yusufElnady/Ultrasound-NDT-Main-Board/Documents/jlc_BOM.xlsx

Comment | Designator | Footprint | Quantity
4 pF | C201,C207 | Capacitor_SMD:C_0603_1608Metric | 2
22 pF | C202,C206 | Capacitor_SMD:C_0603_1608Metric | 2
1uF | C203,C209,C601,C603,C606,C613,C614 | Capacitor_SMD:C_0603_1608Metric | 7
22uF | C204,C505,C506,C507,C511,C512 | Capacitor_SMD:C_0805_2012Metric | 6
150pF | C205,C208 | Capacitor_SMD:C_0603_1608Metric | 2
100nF | C210,C211,C212,C213,C401,C501,C508 | Capacitor_SMD:C_0603_1608Metric | 7
1pF | C301,C305 | Capacitor_SMD:C_0402_1005Metric | 2
0.9pF | C302 | Capacitor_SMD:C_0402_1005Metric | 1
0.6pF | C303 | Capacitor_SMD:C_0402_1005Metric | 1
100pF | C304,C312,C315,C316,C322 | Capacitor_SMD:C_0402_1005Metric | 5
12pF | C306,C307 | Capacitor_SMD:C_0402_1005Metric | 2
3pF | C308,C309,C313 | Capacitor_SMD:C_0402_1005Metric | 3
7pF | C310 | Capacitor_SMD:C_0402_1005Metric | 1
3.9pF | C311,C321,C323 | Capacitor_SMD:C_0402_1005Metric | 3
2.6pF | C314 | Capacitor_SMD:C_0402_1005Metric | 1
2.4pF | C317,C318 | Capacitor_SMD:C_0402_1005Metric | 2
1.1pF | C319 | Capacitor_SMD:C_0402_1005Metric | 1
5.1pF | C320 | Capacitor_SMD:C_0402_1005Metric | 1
10uF | C502,C503,C504,C509,C510 | Capacitor_SMD:C_0805_2012Metric | 5
LED | D201,D501,D502,D503,D504 | LED_SMD:LED_0805_2012Metric | 5
015402.5DR | F501 | 015402.5DR:0154Series_LTF | 1
0154001.DR | F502,F503,F504,F505 | 0154001.DR:FUSE_0154001.DR | 4
1.5K 0.5A | FB501 | Inductor_SMD:L_0603_1608Metric | 1
6.8uH | L201 | Inductor_SMD:L_0805_2012Metric | 1
20nH | L301 | Inductor_SMD:L_0402_1005Metric | 1
3.7nH | L302,L303 | Inductor_SMD:L_0402_1005Metric | 2
3.4nH | L304,L311,L312 | Inductor_SMD:L_0402_1005Metric | 3
3.9nH | L305 | Inductor_SMD:L_0402_1005Metric | 1
10nH | L306,L308 | Inductor_SMD:L_0402_1005Metric | 2
22nH | L307 | Inductor_SMD:L_0402_1005Metric | 1
6.8nH | L309,L310 | Inductor_SMD:L_0402_1005Metric | 2
0.6nH | L313 | Inductor_SMD:L_0402_1005Metric | 1
1nH | L314,L315 | Inductor_SMD:L_0402_1005Metric | 2
12nH | L316,L318 | Inductor_SMD:L_0402_1005Metric | 2
27nH | L317 | Inductor_SMD:L_0402_1005Metric | 1
3nH | L319 | Inductor_SMD:L_0402_1005Metric | 1
5.1nH | L320 | Inductor_SMD:L_0402_1005Metric | 1
1.9nH | L321 | Inductor_SMD:L_0402_1005Metric | 1
TPSM84338RCJR | PS501 | TPSM84338RCJR:CONV_TPSM84338RCJR | 1
1k | R201,R202,R203,R204,R206,R207,R208,R209,R210,R211,R212,R213,R504 | Resistor_SMD:R_0603_1608Metric | 13
330R | R205,R508,R509 | Resistor_SMD:R_0603_1608Metric | 3
2.2K | R401,R402,R403 | Resistor_SMD:R_0603_1608Metric | 3
3k | R501 | Resistor_SMD:R_0603_1608Metric | 1
2k | R502 | Resistor_SMD:R_0603_1608Metric | 1
18k | R503 | Resistor_SMD:R_0603_1608Metric | 1
72.3k | R505 | Resistor_SMD:R_0603_1608Metric | 1
10k | R506 | Resistor_SMD:R_0603_1608Metric | 1
500R | R507 | Resistor_SMD:R_0603_1608Metric | 1
6.65k | R601,R611 | Resistor_SMD:R_0603_1608Metric | 2
1.91k | R602,R603,R607,R608 | Resistor_SMD:R_0603_1608Metric | 4
1.5k | R604,R606 | Resistor_SMD:R_0603_1608Metric | 2
CC1354P106T0RGZR | U201 | CC1354P106T0RGZR:VQFN48_RGZ_TEX | 1
LTC1694CS5TRMPBF | U202 | LTC1694CS5TRMPBF:SOT95P280X100-5N | 1
MX25R1635FZUIL0 | U401 | MX25R1635FZUIL0:USON-8L-2X3X0P6_MAC | 1
AZ1117CH2-3.3 | U501,U502 | Package_TO_SOT_SMD:SOT-223-3_TabPin2 | 2
TLV9002IDR | U602 | TLV9002IDR:SOIC127P599X175-8N | 1
ABM11W-48.0000MHZ-7-B1U-T3 | Y201 | ABM11W-48.0000MHZ-7-B1U-T3:XTAL_ABM11W-48.0000MHZ-7-B1U-T3 | 1
ABS07-32.768KHZ-T | Y202 | ABS07-32.768KHZ-T:XTAL_ABS07-32.768KHZ-T | 1
