yusufElnady/Ultrasound-NDT-Main-Board/Main Board - NDT.kicad_pcb

## KiCad design Main Board - NDT.kicad_pcb (2026-04-28)

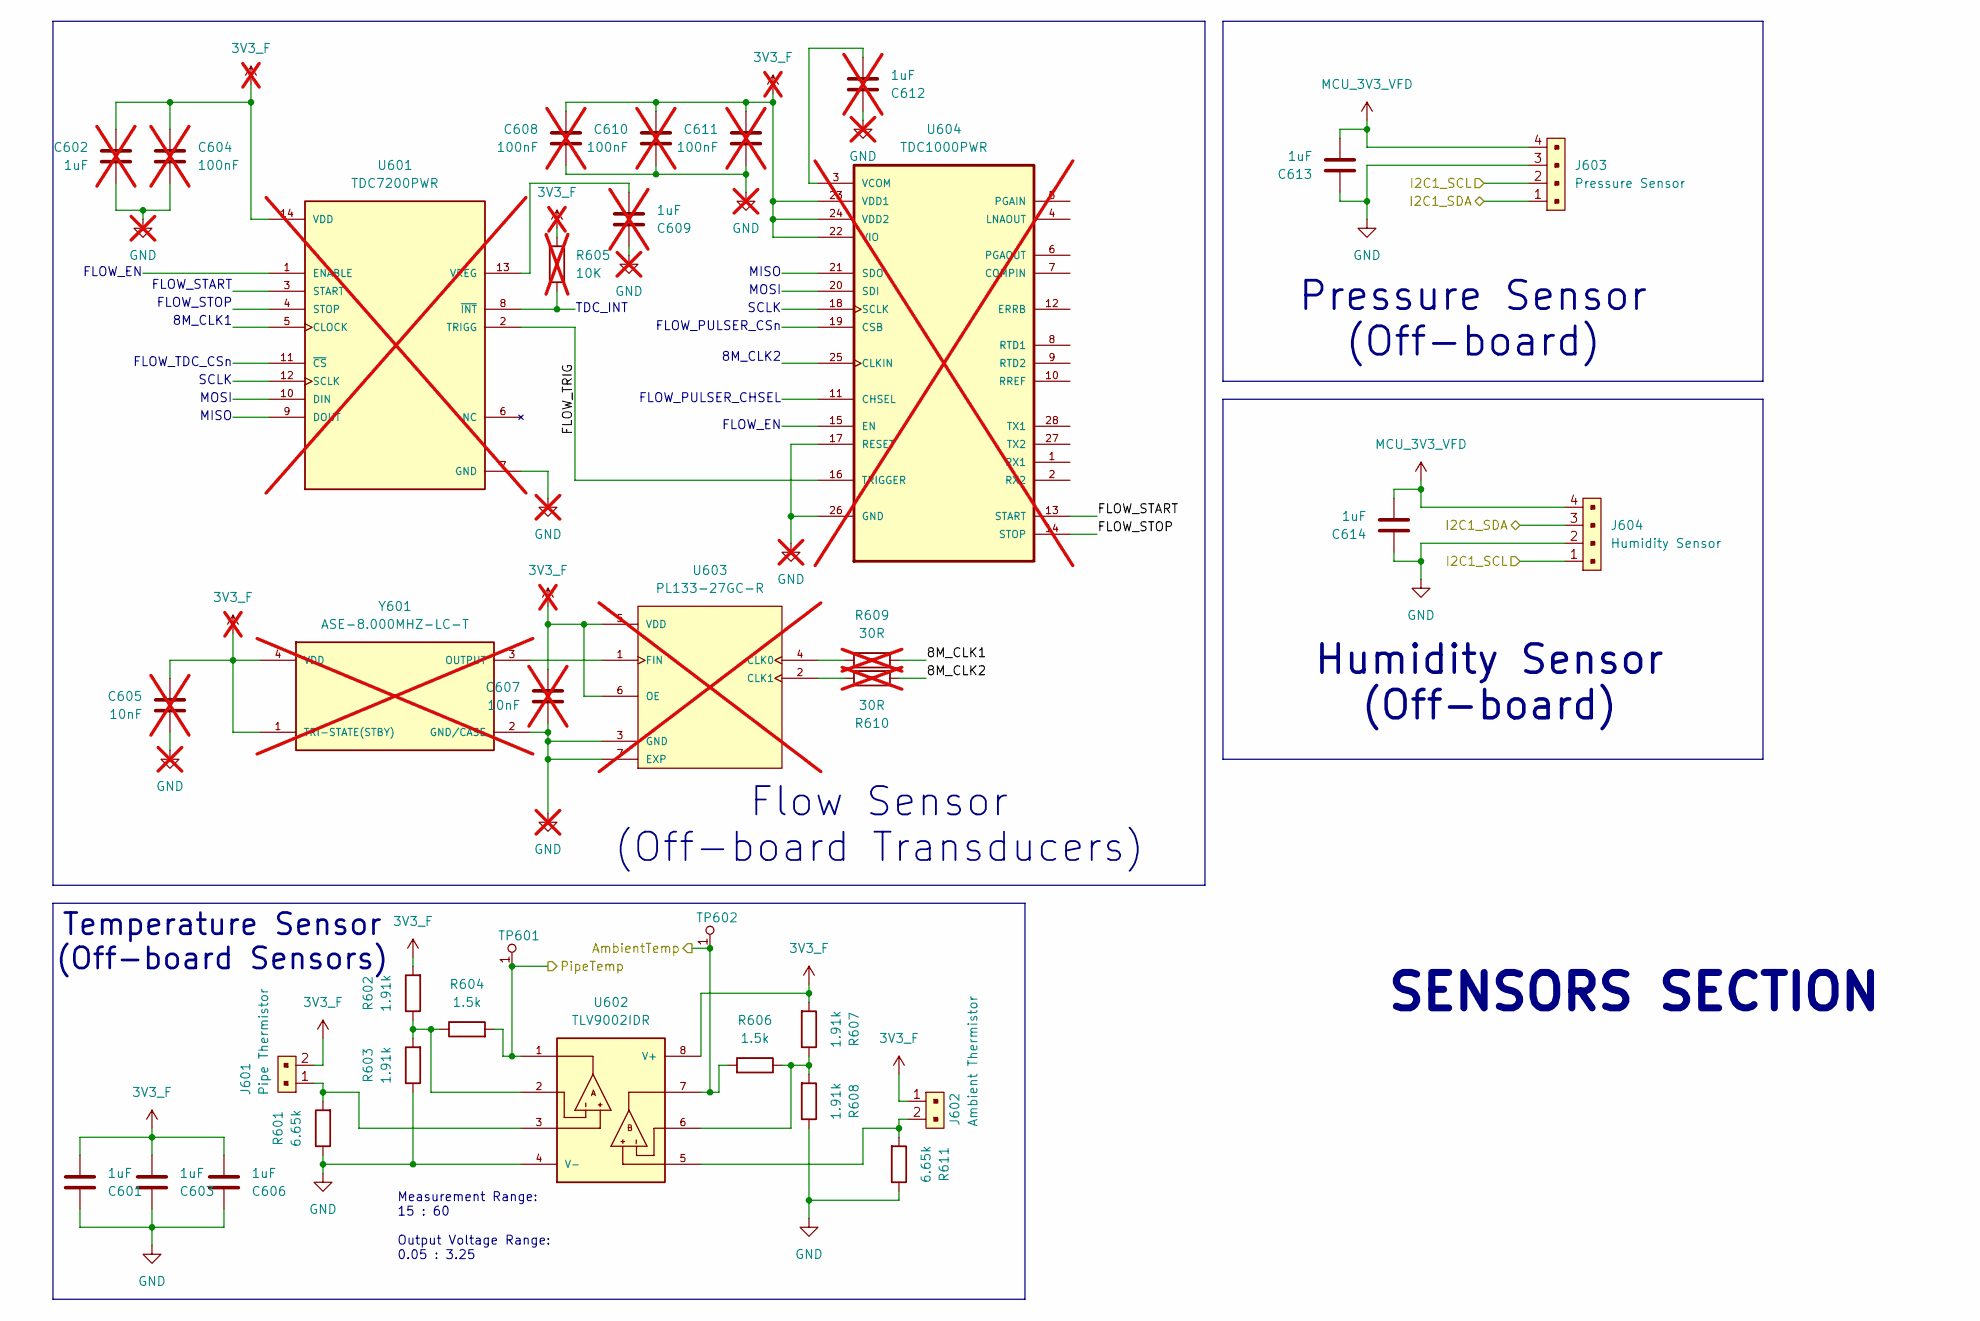
[picture p7: schematic sensors.kicad_sch]

Parts:
C601, C603, C606, C613, C614: 1uF; C_0603_1608Metric
C602, C609, C612: 1uF; not fitted
C604, C608, C610, C611: 100nF; C_0603_1608Metric; not fitted
C605, C607: 10nF; C_0603_1608Metric; not fitted
J601: Pipe Thermistor; PinHeader_1x2_P2mm_Drill1mm_RA; MPN S2B-PH-K-S(LF)(SN); Digi-Key_PN 455-1719-ND
J602: Ambient Thermistor; PinHeader_1x2_P2mm_Drill1mm_RA; MPN S2B-PH-K-S(LF)(SN); Digi-Key_PN 455-1719-ND
J603: Pressure Sensor; PinHeader_1x4_P2.5mm_Drill1.1mm; MPN B4B-XH-A(LF)(SN); Digi-Key_PN 455-2249-ND
J604: Humidity Sensor; PinHeader_1x4_P2.5mm_Drill1.1mm; MPN B4B-XH-A(LF)(SN); Digi-Key_PN 455-2249-ND
R601, R611: 6.65k; R_0603_1608Metric
R602, R603, R607, R608: 1.91k; R_0603_1608Metric
R604, R606: 1.5k; R_0603_1608Metric
R605: 10K; not fitted
R609, R610: 30R; not fitted
TP601, TP602: RCT-0C; PROBE_PAD_0805; MPN RCT-0C; Digi-Key_PN A106144CT-ND
U601: TDC7200PWR; SOP65P640X120-14N; PARTREV D; not fitted
U602: TLV9002IDR; SOIC127P599X175-8N; PARTREV O
U603: PL133-27GC-R; SON40P130X200X60-7N; PARTREV 09/13/13; not fitted
U604: TDC1000PWR; SOP65P640X120-28N; not fitted
Y601: ASE-8.000MHZ-LC-T; XTAL_ASE-8.000MHZ-LC-T; PARTREV 02-18-22; not fitted

Connections:
3V3_F: C601.2, C602.1, C603.2, C604.1, C605.1, C606.2, C607.1, C608.1, C610.1, C611.1, J601.2, J602.1, R602.2, R605.1, R607.2, U601.14 (VDD), U602.8 (V+), U603.5 (VDD), U603.6 (OE), U604.22 (VIO), U604.23 (VDD1), U604.24 (VDD2), Y601.1 (TRI-STATE(STBY)), Y601.4 (VDD); also elsewhere on the board
/MCU/AmbientTemp: R606.2, TP602.1, U602.7; also elsewhere on the board
/MCU/I2C1_SCL: J603.2, J604.1; also elsewhere on the board
/MCU/I2C1_SDA: J603.1, J604.3; also elsewhere on the board
/MCU/PipeTemp: R604.2, TP601.1, U602.1; also elsewhere on the board
GND: C601.1, C602.2, C603.1, C604.2, C605.2, C606.1, C607.2, C608.2, C609.1, C610.2, C611.2, C612.1, C613.1, C614.1, J603.3, J604.2, R601.1, R603.1, R608.1, R611.1, U601.7 (GND), U602.4 (V-), U603.3 (GND), U603.7 (EXP), U604.17 (RESET), U604.26 (GND), Y601.2 (GND/CASE); also elsewhere on the board
MCU_3V3_VFD: C613.2, C614.2, J603.4, J604.4; also elsewhere on the board
unnamed: C609.2, U601.13 (VREG)
unnamed: C612.2, U604.3 (VCOM)
unnamed: J601.1, R601.2, U602.3
unnamed: J602.2, R611.2, U602.5
unnamed: R602.1, R603.2, R604.1, U602.2
unnamed: R605.2, U601.8 (~INT)
unnamed: R606.1, R607.1, R608.2, U602.6
unnamed: R609.1, U603.4 (CLK0)
unnamed: R610.2, U603.2 (CLK1)
unnamed: U601.2 (TRIGG), U604.16 (TRIGGER)
unnamed: U603.1 (FIN), Y601.3 (OUTPUT)

Notes on the sheet:
SCLK
MISO
FLOW_STOP
MOSI
FLOW_TDC_CSn
Pressure Sensor (Off-board)
Humidity Sensor (Off-board)
Measurement Range: 15 : 60 Output Voltage Range: 0.05 : 3.25
Flow Sensor (Off-board Transducers)
FLOW_PULSER_CHSEL
FLOW_EN
SENSORS SECTION
FLOW_START
TDC_INT
8M_CLK2
8M_CLK1
Temperature Sensor (Off-board Sensors)
FLOW_PULSER_CSn

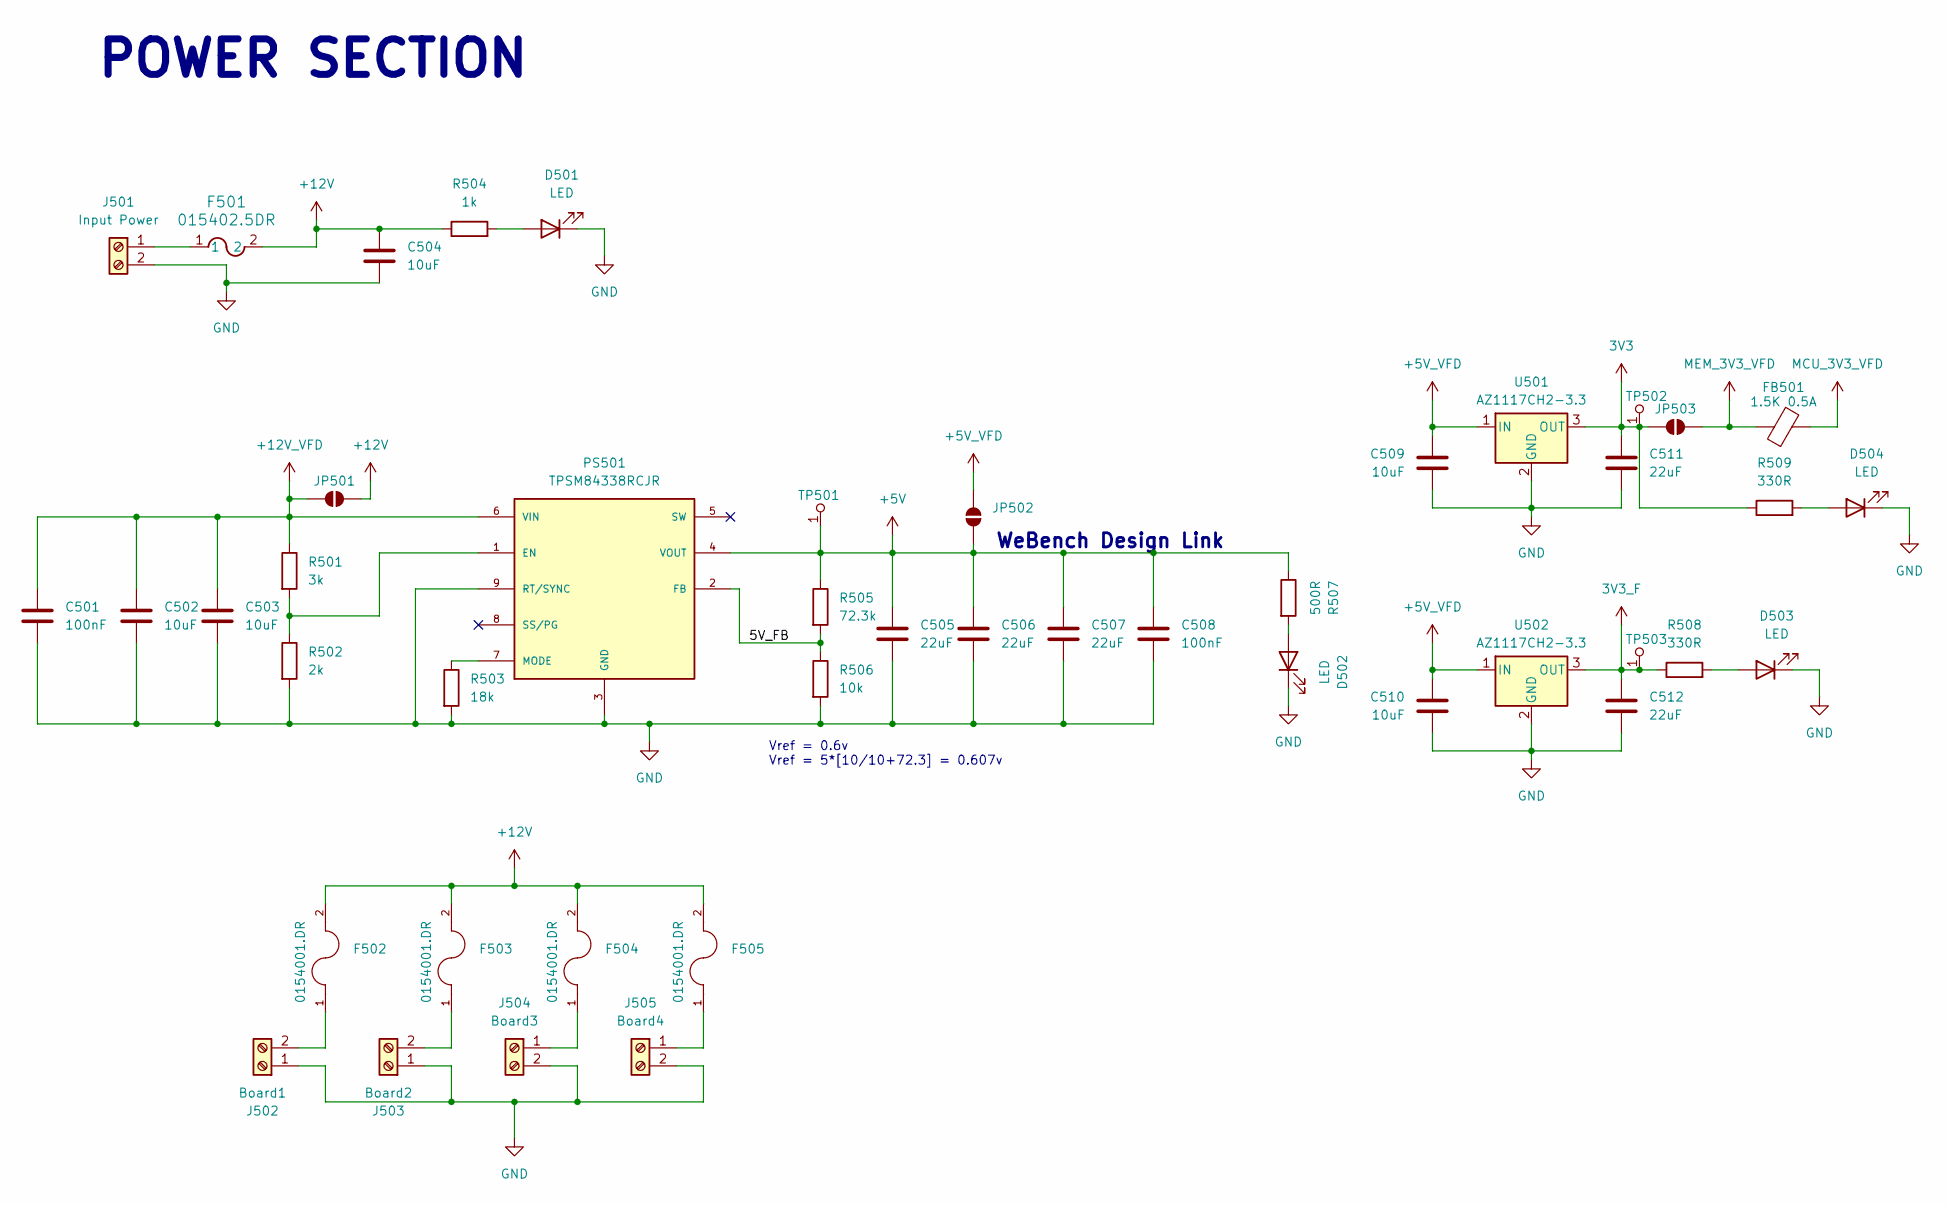
[picture p8: schematic Power.kicad_sch]

Parts:
C501, C508: 100nF; C_0603_1608Metric
C502, C503, C504, C509, C510: 10uF; C_0805_2012Metric
C505, C506, C507, C511, C512: 22uF; C_0805_2012Metric
D501, D502, D503, D504: LED; LED_0805_2012Metric
F501: 015402.5DR; 0154Series_LTF
F502, F503, F504, F505: 0154001.DR; FUSE_0154001.DR; PARTREV GD
FB501: 1.5K 0.5A; L_0603_1608Metric
J501: Input Power; TerminalBlock_MaiXu_MX126-5.0-02P_1x02_P5.00mm
J502: Board1; TerminalBlock_MaiXu_MX126-5.0-02P_1x02_P5.00mm
J503: Board2; TerminalBlock_MaiXu_MX126-5.0-02P_1x02_P5.00mm
J504: Board3; TerminalBlock_MaiXu_MX126-5.0-02P_1x02_P5.00mm
J505: Board4; TerminalBlock_MaiXu_MX126-5.0-02P_1x02_P5.00mm
JP501: SolderJumper_2_Open; SolderJumper-2_P1.3mm_Open_RoundedPad1.0x1.5mm
JP502, JP503: SolderJumper_2_Open; SolderJumper-2_P1.3mm_Open_Pad1.0x1.5mm
PS501: TPSM84338RCJR; CONV_TPSM84338RCJR; PARTREV November 2024
R501: 3k; R_0603_1608Metric
R502: 2k; R_0603_1608Metric
R503: 18k; R_0603_1608Metric
R504: 1k; R_0603_1608Metric
R505: 72.3k; R_0603_1608Metric
R506: 10k; R_0603_1608Metric
R507: 500R; R_0603_1608Metric
R508, R509: 330R; R_0603_1608Metric
TP501, TP502, TP503: RCT-0C; PROBE_PAD_0805; MPN RCT-0C; Digi-Key_PN A106144CT-ND
U501, U502: AZ1117CH2-3.3; SOT-223-3_TabPin2

Connections:
3V3: C511.1, JP503.1 (A), R509.1, TP502.1, U501.3 (OUT)
3V3_F: C512.1, R508.1, TP503.1, U502.3 (OUT); also elsewhere on the board
+5V: C505.1, C506.1, C507.1, C508.1, JP502.1 (A), PS501.4 (VOUT), R505.1, R507.1, TP501.1
+5V_VFD: C509.1, C510.1, JP502.2 (B), U501.1 (IN), U502.1 (IN); also elsewhere on the board
+12V: C504.1, F501.2, F502.2, F503.2, F504.2, F505.2, JP501.2 (B), R504.1
+12V_VFD: C501.1, C502.1, C503.1, JP501.1 (A), PS501.6 (VIN), R501.1
/Power/5V_FB: PS501.2 (FB), R505.2, R506.1
GND: C501.2, C502.2, C503.2, C504.2, C505.2, C506.2, C507.2, C508.2, C509.2, C510.2, C511.2, C512.2, D501.1 (K), D502.1 (K), D503.1 (K), D504.1 (K), J501.2, J502.1, J503.1, J504.2, J505.2, PS501.3 (GND), PS501.9 (RT/SYNC), R502.2, R503.2, R506.2, U501.2 (GND), U502.2 (GND); also elsewhere on the board
MCU_3V3_VFD: FB501.2; also elsewhere on the board
MEM_3V3_VFD: FB501.1, JP503.2 (B); also elsewhere on the board
unnamed: D501.2 (A), R504.2
unnamed: D502.2 (A), R507.2
unnamed: D503.2 (A), R508.2
unnamed: D504.2 (A), R509.2
unnamed: F501.1, J501.1
unnamed: F502.1, J502.2
unnamed: F503.1, J503.2
unnamed: F504.1, J504.1
unnamed: F505.1, J505.1
unnamed: PS501.1 (EN), R501.2, R502.1
unnamed: PS501.7 (MODE), R503.1

Notes on the sheet:
WeBench Design Link
Vref = 0.6v Vref = 5*[10/10+72.3] = 0.607v
POWER SECTION

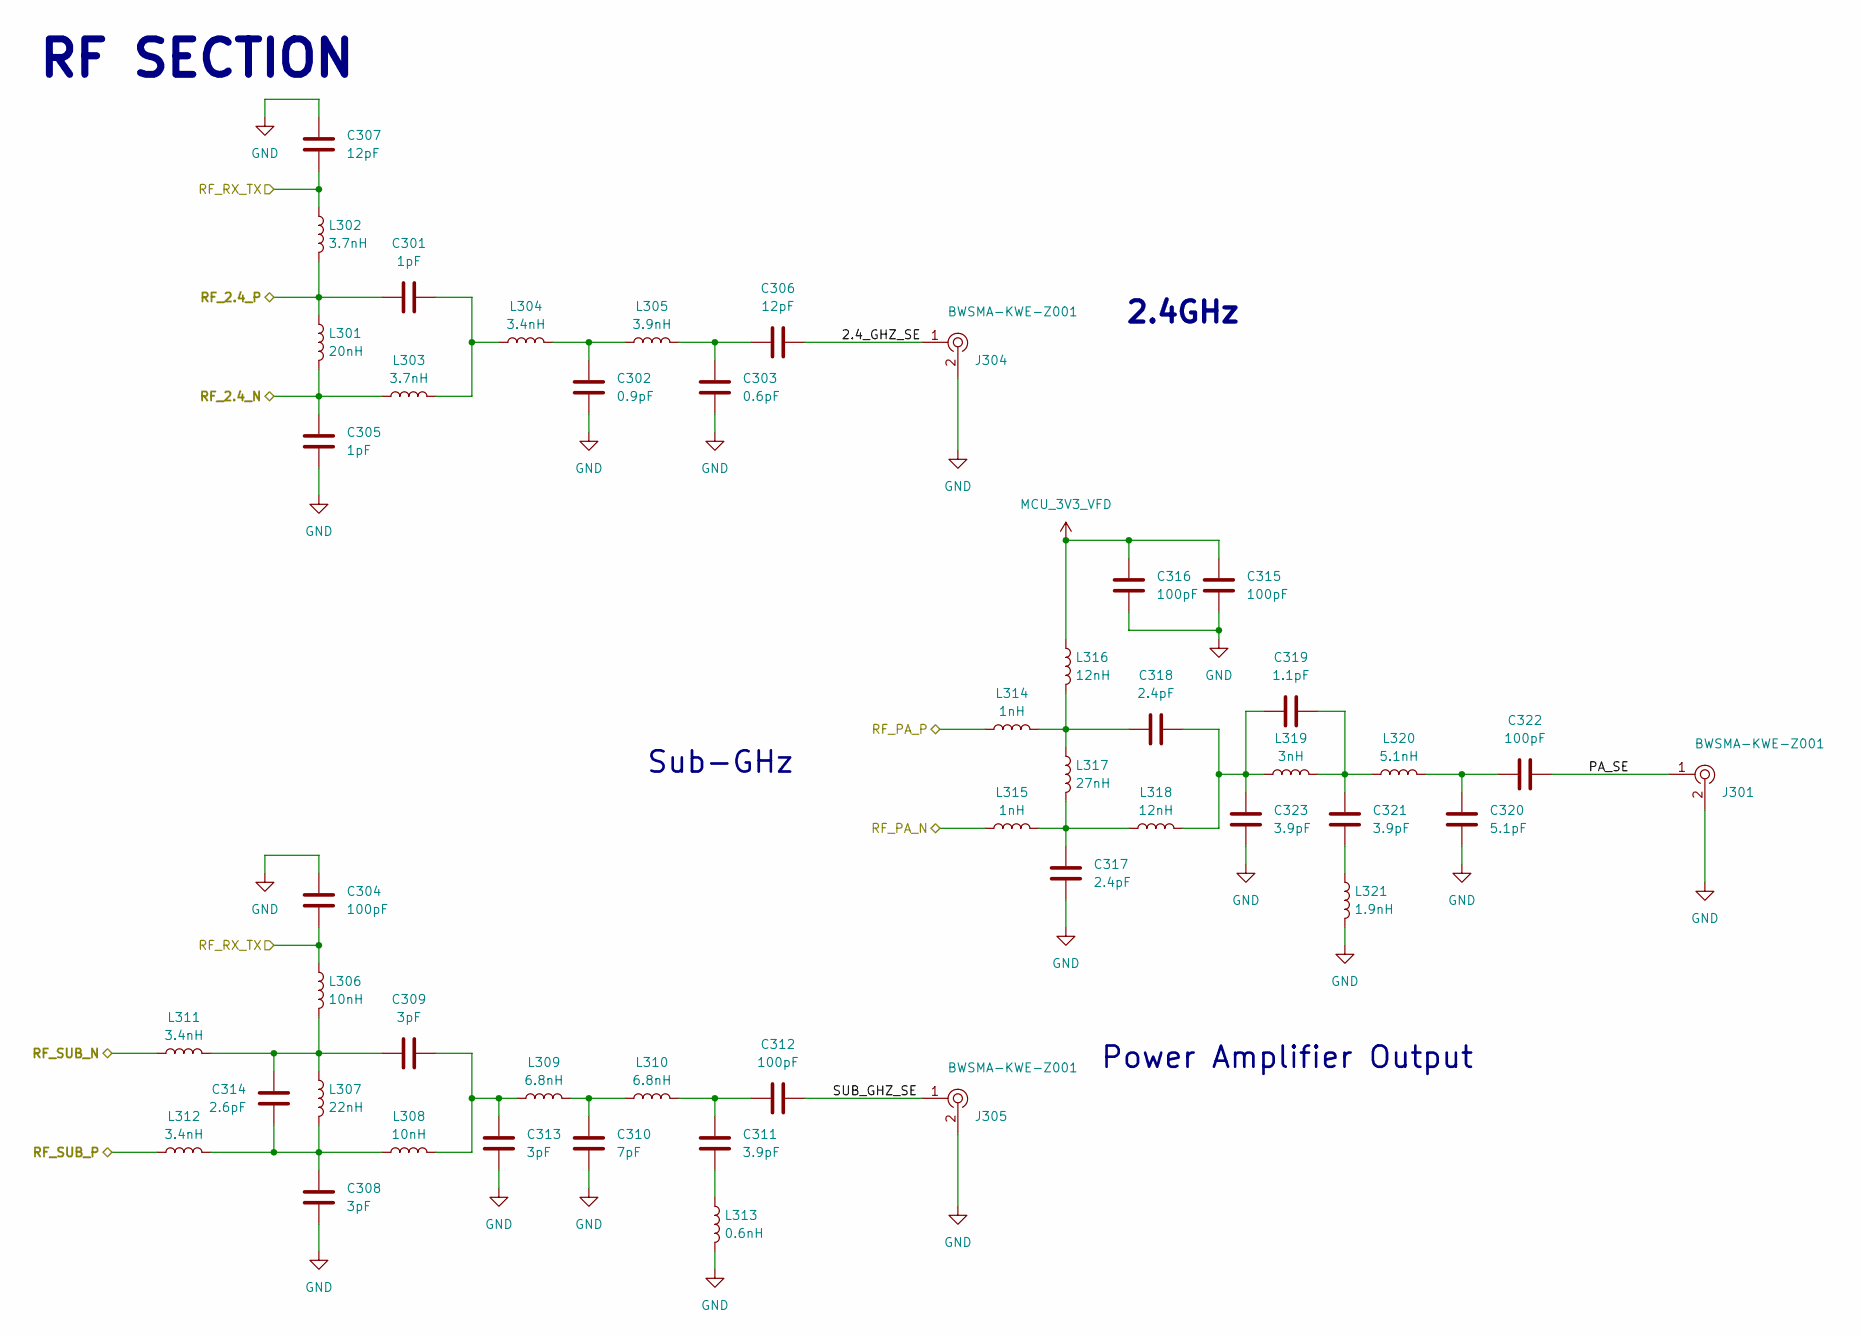
[picture p9: schematic RF.kicad_sch]

Parts:
C301, C305: 1pF; C_0402_1005Metric
C302: 0.9pF; C_0402_1005Metric
C303: 0.6pF; C_0402_1005Metric
C304, C312, C315, C316, C322: 100pF; C_0402_1005Metric
C306, C307: 12pF; C_0402_1005Metric
C308, C309, C313: 3pF; C_0402_1005Metric
C310: 7pF; C_0402_1005Metric
C311, C321, C323: 3.9pF; C_0402_1005Metric
C314: 2.6pF; C_0402_1005Metric
C317, C318: 2.4pF; C_0402_1005Metric
C319: 1.1pF; C_0402_1005Metric
C320: 5.1pF; C_0402_1005Metric
J301, J304, J305: BWSMA-KWE-Z001; RF_SMA_RightAngle_5-1814400-1; MPN BWSMA-KWE-Z001; LCSC PN C496551
L301: 20nH; L_0402_1005Metric
L302, L303: 3.7nH; L_0402_1005Metric
L304, L311, L312: 3.4nH; L_0402_1005Metric
L305: 3.9nH; L_0402_1005Metric
L306, L308: 10nH; L_0402_1005Metric
L307: 22nH; L_0402_1005Metric
L309, L310: 6.8nH; L_0402_1005Metric
L313: 0.6nH; L_0402_1005Metric
L314, L315: 1nH; L_0402_1005Metric
L316, L318: 12nH; L_0402_1005Metric
L317: 27nH; L_0402_1005Metric
L319: 3nH; L_0402_1005Metric
L320: 5.1nH; L_0402_1005Metric
L321: 1.9nH; L_0402_1005Metric

Connections:
/MCU/RF_2.4_N: C301.1, L301.1, L302.2; also elsewhere on the board
/MCU/RF_2.4_P: C305.2, L301.2, L303.1; also elsewhere on the board
/MCU/RF_PA_N: L315.1; also elsewhere on the board
/MCU/RF_PA_P: L314.1; also elsewhere on the board
/MCU/RF_RX_TX: C304.1, C307.1, L302.1, L306.1; also elsewhere on the board
/MCU/RF_SUB_N: L311.1; also elsewhere on the board
/MCU/RF_SUB_P: L312.1; also elsewhere on the board
/RF/2.4_GHZ_SE: C306.2, J304.1
/RF/PA_SE: C322.1, J301.1
/RF/SUB_GHZ_SE: C312.1, J305.1
GND: C302.1, C303.1, C304.2, C305.1, C307.2, C308.1, C310.1, C313.1, C315.1, C316.1, C317.1, C320.1, C323.1, J301.2, J304.2, J305.2, L313.2, L321.2; also elsewhere on the board
MCU_3V3_VFD: C315.2, C316.2, L316.1; also elsewhere on the board
unnamed: C301.2, L303.2, L304.1
unnamed: C302.2, L304.2, L305.1
unnamed: C303.2, C306.1, L305.2
unnamed: C308.2, C314.2, L307.2, L308.1, L312.2
unnamed: C309.1, C314.1, L306.2, L307.1, L311.2
unnamed: C309.2, C313.2, L308.2, L309.1
unnamed: C310.2, L309.2, L310.1
unnamed: C311.1, L313.1
unnamed: C311.2, C312.2, L310.2
unnamed: C317.2, L315.2, L317.2, L318.1
unnamed: C318.1, L314.2, L316.2, L317.1
unnamed: C318.2, C319.1, C323.2, L318.2, L319.1
unnamed: C319.2, C321.2, L319.2, L320.1
unnamed: C320.2, C322.2, L320.2
unnamed: C321.1, L321.1

Notes on the sheet:
RF SECTION
Power Amplifier Output
Sub-GHz
2.4GHz

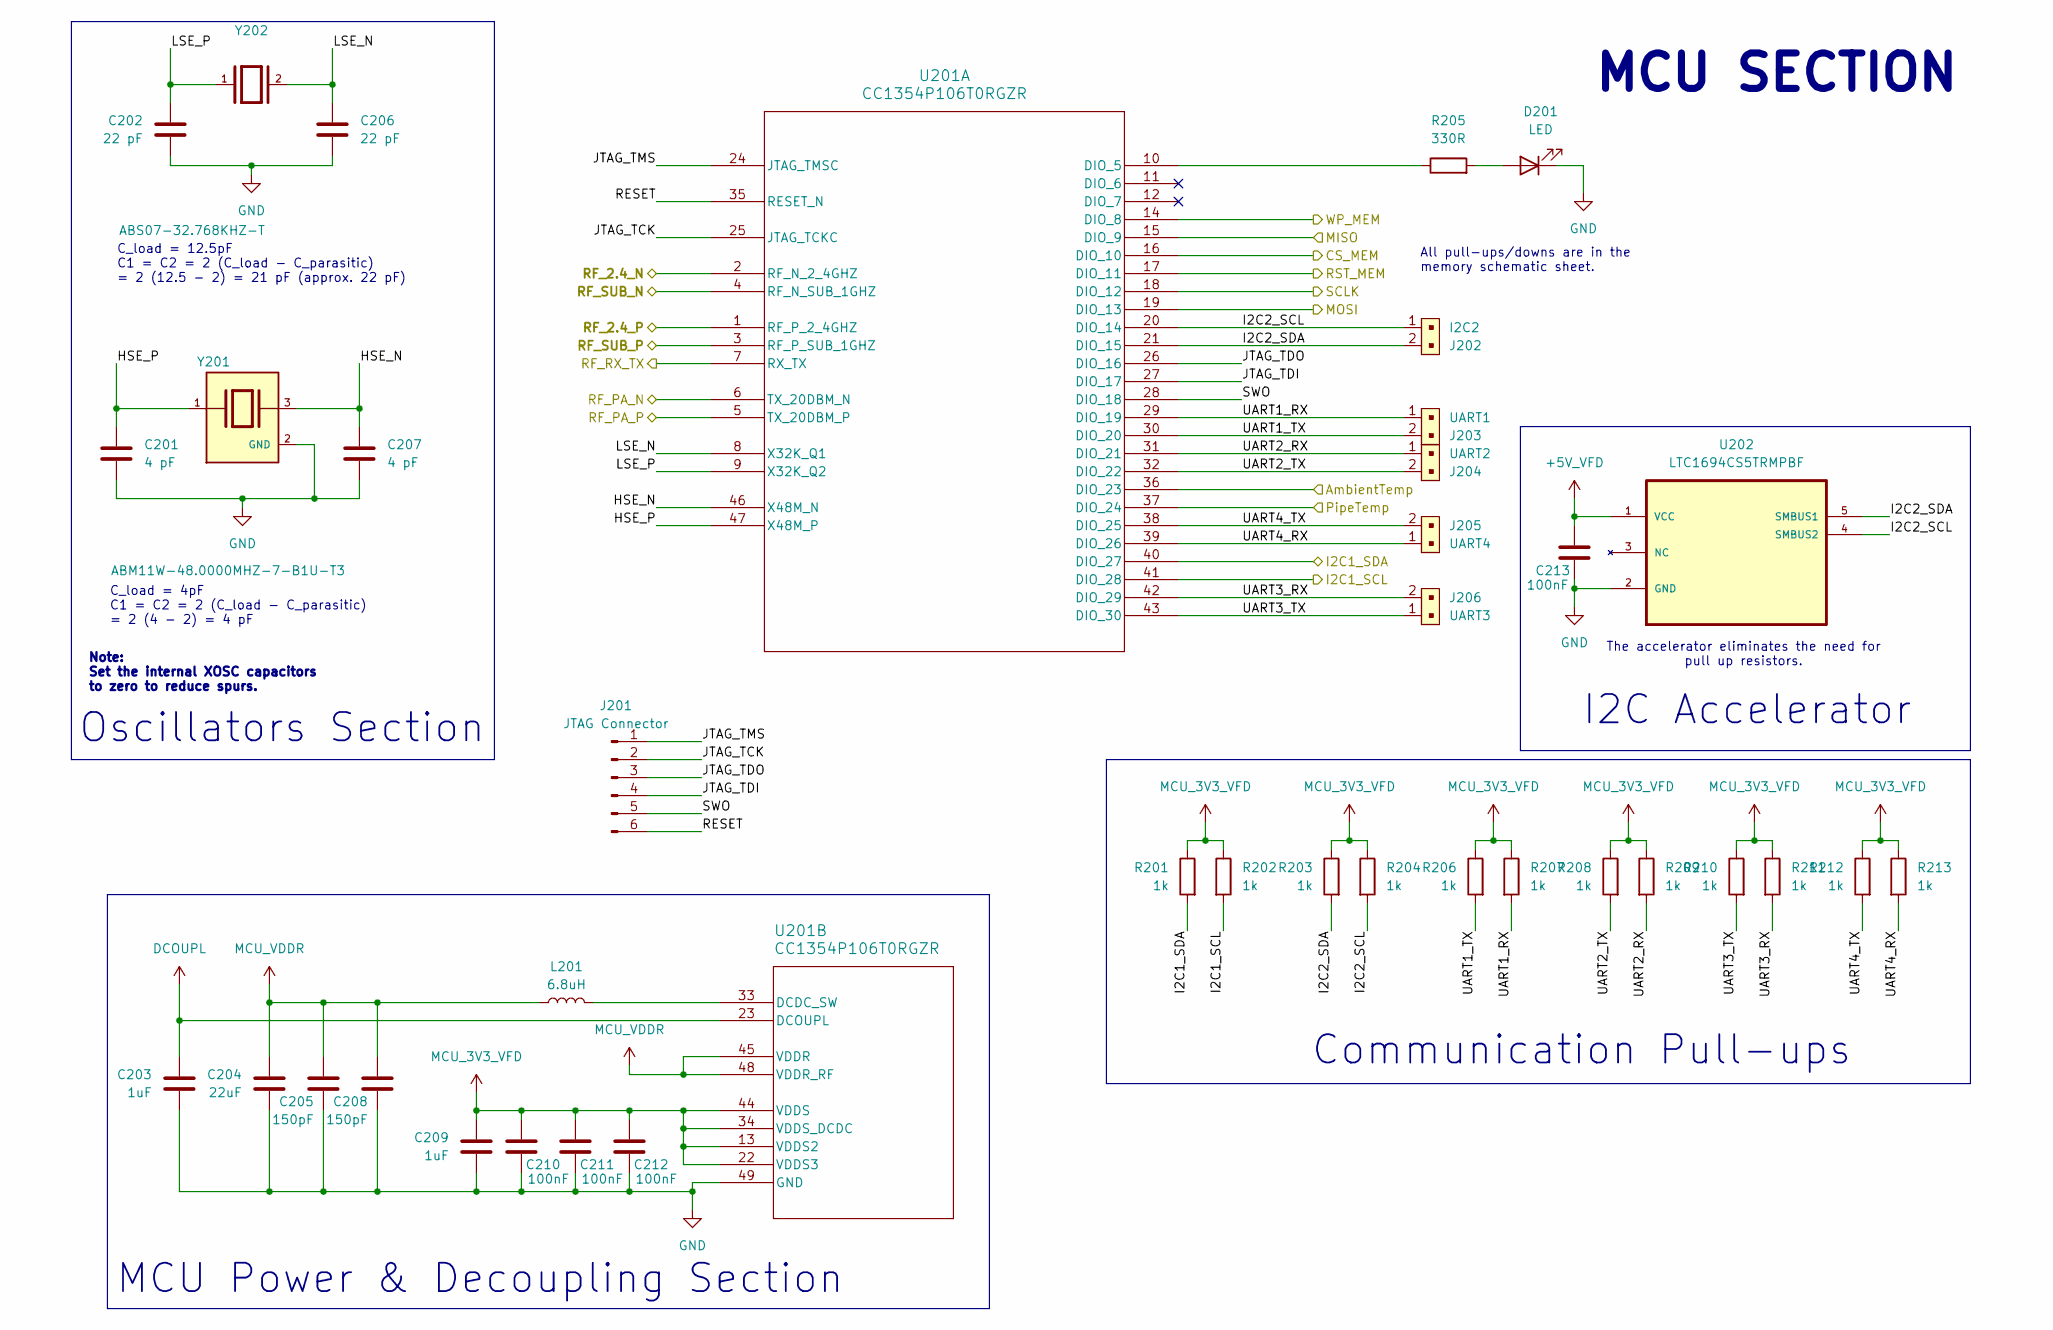
[picture p10: schematic MCU.kicad_sch]

Parts:
C201, C207: 4 pF; C_0603_1608Metric
C202, C206: 22 pF; C_0603_1608Metric
C203, C209: 1uF; C_0603_1608Metric
C204: 22uF; C_0805_2012Metric
C205, C208: 150pF; C_0603_1608Metric
C210, C211, C212, C213: 100nF; C_0603_1608Metric
D201: LED; LED_0805_2012Metric
J201: JTAG Connector; PinHeader_1x06_P2.54mm_Vertical
J202: I2C2; PinHeader_1x2_P2mm_Drill1mm_RA; MPN S2B-PH-K-S(LF)(SN); Digi-Key_PN 455-1719-ND
J203: UART1; PinHeader_1x2_P2mm_Drill1mm_RA; MPN S2B-PH-K-S(LF)(SN); Digi-Key_PN 455-1719-ND
J204: UART2; PinHeader_1x2_P2mm_Drill1mm_RA; MPN S2B-PH-K-S(LF)(SN); Digi-Key_PN 455-1719-ND
J205: UART4; PinHeader_1x2_P2mm_Drill1mm_RA; MPN S2B-PH-K-S(LF)(SN); Digi-Key_PN 455-1719-ND
J206: UART3; PinHeader_1x2_P2mm_Drill1mm_RA; MPN S2B-PH-K-S(LF)(SN); Digi-Key_PN 455-1719-ND
L201: 6.8uH; L_0805_2012Metric
R201, R202, R203, R204, R206, R207, R208, R209, R210, R211, R212, R213: 1k; R_0603_1608Metric
R205: 330R; R_0603_1608Metric
U201: CC1354P106T0RGZR; VQFN48_RGZ_TEX
U202: LTC1694CS5TRMPBF; SOT95P280X100-5N; MPN LTC1694CS5#TRMPBF
Y201: ABM11W-48.0000MHZ-7-B1U-T3; XTAL_ABM11W-48.0000MHZ-7-B1U-T3; PARTREV 10.06.2020
Y202: ABS07-32.768KHZ-T; XTAL_ABS07-32.768KHZ-T; PARTREV 08.19.15

Connections:
+5V_VFD: C213.1, U202.1 (VCC); also elsewhere on the board
/MCU/AmbientTemp: U201.36 (DIO_23); also elsewhere on the board
/MCU/CS_MEM: U201.16 (DIO_10); also elsewhere on the board
/MCU/HSE_N: C207.1, U201.46 (X48M_N), Y201.3
/MCU/HSE_P: C201.1, U201.47 (X48M_P), Y201.1
/MCU/I2C1_SCL: R202.2, U201.41 (DIO_28); also elsewhere on the board
/MCU/I2C1_SDA: R201.2, U201.40 (DIO_27); also elsewhere on the board
/MCU/I2C2_SCL: J202.1, R204.2, U201.20 (DIO_14), U202.4 (SMBUS2)
/MCU/I2C2_SDA: J202.2, R203.2, U201.21 (DIO_15), U202.5 (SMBUS1)
/MCU/JTAG_TCK: J201.2, U201.25 (JTAG_TCKC)
/MCU/JTAG_TDI: J201.4, U201.27 (DIO_17)
/MCU/JTAG_TDO: J201.3, U201.26 (DIO_16)
/MCU/JTAG_TMS: J201.1, U201.24 (JTAG_TMSC)
/MCU/LSE_N: C206.1, U201.8 (X32K_Q1), Y202.2
/MCU/LSE_P: C202.1, U201.9 (X32K_Q2), Y202.1
/MCU/MISO: U201.15 (DIO_9); also elsewhere on the board
/MCU/MOSI: U201.19 (DIO_13); also elsewhere on the board
/MCU/PipeTemp: U201.37 (DIO_24); also elsewhere on the board
/MCU/RESET: J201.6, U201.35 (RESET_N)
/MCU/RF_2.4_N: U201.2 (RF_N_2_4GHZ); also elsewhere on the board
/MCU/RF_2.4_P: U201.1 (RF_P_2_4GHZ); also elsewhere on the board
/MCU/RF_PA_N: U201.6 (TX_20DBM_N); also elsewhere on the board
/MCU/RF_PA_P: U201.5 (TX_20DBM_P); also elsewhere on the board
/MCU/RF_RX_TX: U201.7 (RX_TX); also elsewhere on the board
/MCU/RF_SUB_N: U201.4 (RF_N_SUB_1GHZ); also elsewhere on the board
/MCU/RF_SUB_P: U201.3 (RF_P_SUB_1GHZ); also elsewhere on the board
/MCU/RST_MEM: U201.17 (DIO_11); also elsewhere on the board
/MCU/SCLK: U201.18 (DIO_12); also elsewhere on the board
/MCU/SWO: J201.5, U201.28 (DIO_18)
/MCU/UART1_RX: J203.1, R207.2, U201.29 (DIO_19)
/MCU/UART1_TX: J203.2, R206.2, U201.30 (DIO_20)
/MCU/UART2_RX: J204.1, R209.2, U201.31 (DIO_21)
/MCU/UART2_TX: J204.2, R208.2, U201.32 (DIO_22)
/MCU/UART3_RX: J206.2, R211.2, U201.42 (DIO_29)
/MCU/UART3_TX: J206.1, R210.2, U201.43 (DIO_30)
/MCU/UART4_RX: J205.1, R213.2, U201.39 (DIO_26)
/MCU/UART4_TX: J205.2, R212.2, U201.38 (DIO_25)
/MCU/WP_MEM: U201.14 (DIO_8); also elsewhere on the board
DCOUPL: C203.1, U201.23 (DCOUPL)
GND: C201.2, C202.2, C203.2, C204.2, C205.1, C206.2, C207.2, C208.1, C209.2, C210.2, C211.2, C212.2, C213.2, D201.1 (K), U201.49 (GND), U202.2 (GND), Y201.2 (GND), Y201.4 (GND); also elsewhere on the board
MCU_3V3_VFD: C209.1, C210.1, C211.1, C212.1, R201.1, R202.1, R203.1, R204.1, R206.1, R207.1, R208.1, R209.1, R210.1, R211.1, R212.1, R213.1, U201.13 (VDDS2), U201.22 (VDDS3), U201.34 (VDDS_DCDC), U201.44 (VDDS); also elsewhere on the board
MCU_VDDR: C204.1, C205.2, C208.2, L201.1, U201.45 (VDDR), U201.48 (VDDR_RF)
unnamed: D201.2 (A), R205.2
unnamed: R205.1, U201.10 (DIO_5)
unnamed: L201.2, U201.33 (DCDC_SW)

Notes on the sheet:
All pull-ups/downs are in the memory schematic sheet.
Communication Pull-ups
C_load = 12.5pF C1 = C2 = 2 (C_load - C_parasitic) = 2 (12.5 - 2) = 21 pF (approx. 22 pF)
MCU Power & Decoupling Section
Oscillators Section
I2C Accelerator
C_load = 4pF C1 = C2 = 2 (C_load - C_parasitic) = 2 (4 - 2) = 4 pF
Note: Set the internal XOSC capacitors to zero to reduce spurs.
MCU SECTION
The accelerator eliminates the need for pull up resistors.

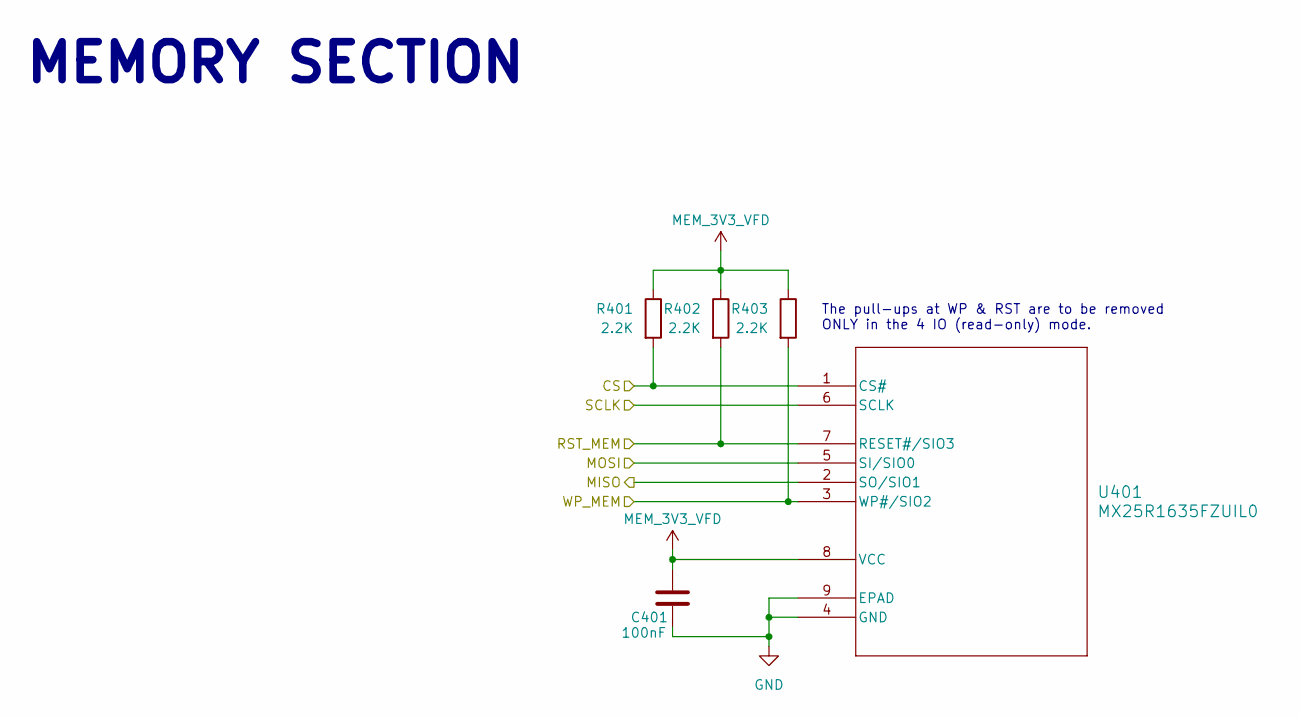
[picture p11: schematic Memory.kicad_sch]

Parts:
C401: 100nF; C_0603_1608Metric
R401, R402, R403: 2.2K; R_0603_1608Metric
U401: MX25R1635FZUIL0; USON-8L-2X3X0P6_MAC

Connections:
/MCU/CS_MEM: R401.2, U401.1 (CS#); also elsewhere on the board
/MCU/MISO: U401.2 (SO/SIO1); also elsewhere on the board
/MCU/MOSI: U401.5 (SI/SIO0); also elsewhere on the board
/MCU/RST_MEM: R402.2, U401.7 (RESET#/SIO3); also elsewhere on the board
/MCU/SCLK: U401.6 (SCLK); also elsewhere on the board
/MCU/WP_MEM: R403.2, U401.3 (WP#/SIO2); also elsewhere on the board
GND: C401.2, U401.4 (GND), U401.9 (EPAD); also elsewhere on the board
MEM_3V3_VFD: C401.1, R401.1, R402.1, R403.1, U401.8 (VCC); also elsewhere on the board

Notes on the sheet:
MEMORY SECTION
The pull-ups at WP & RST are to be removed ONLY in the 4 IO (read-only) mode.

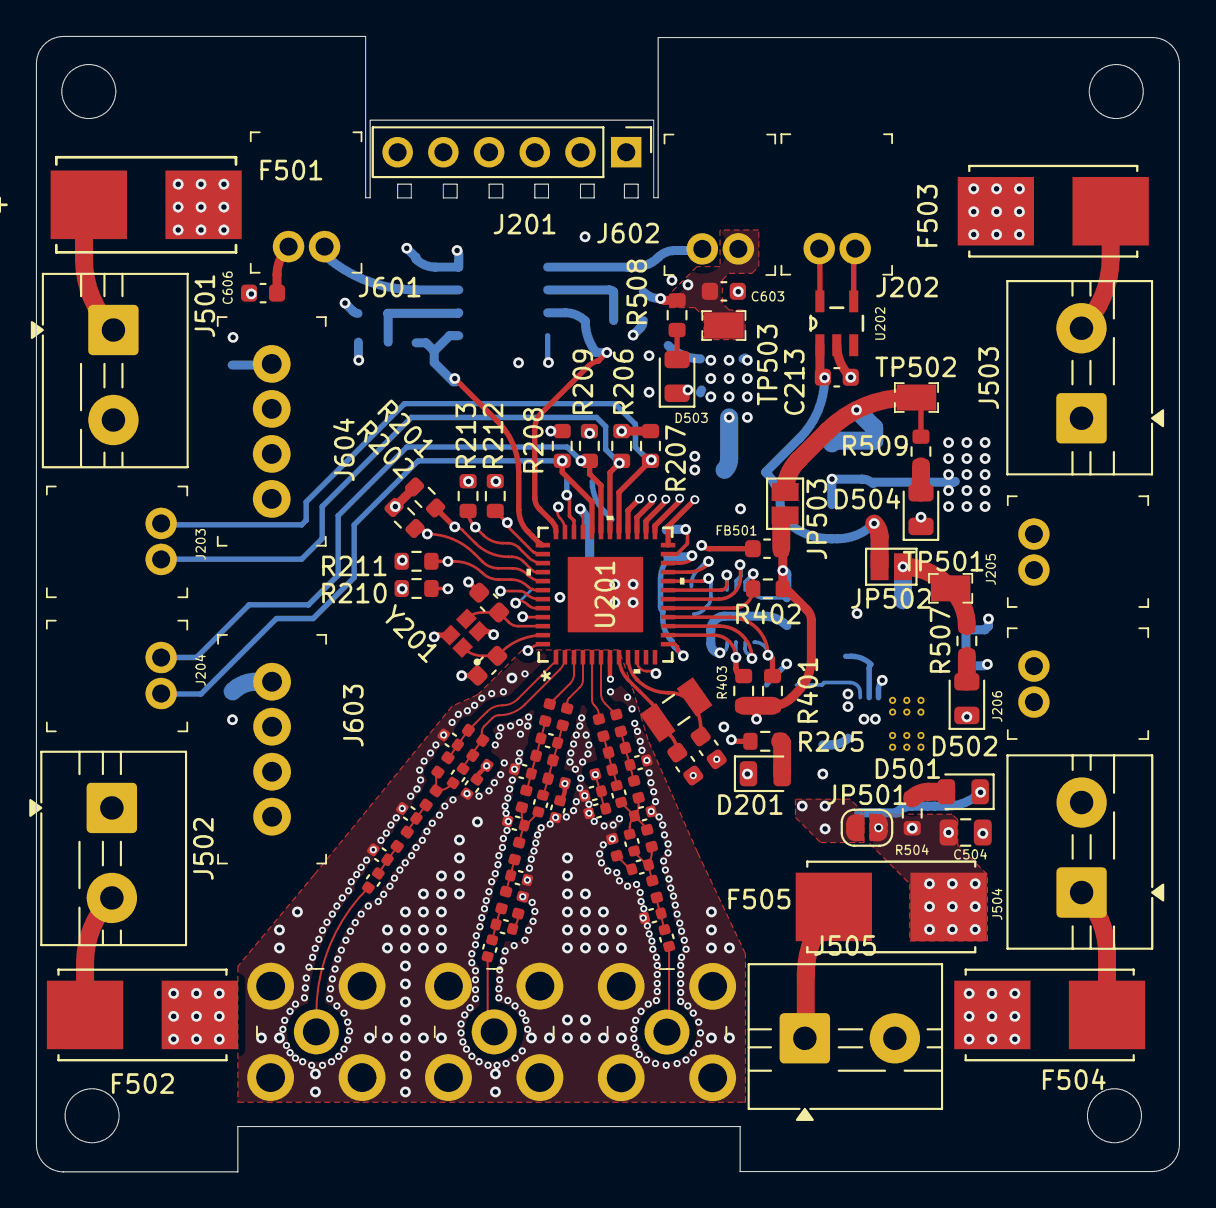
[picture p12: board Main Board - NDT.kicad_pcb from above]

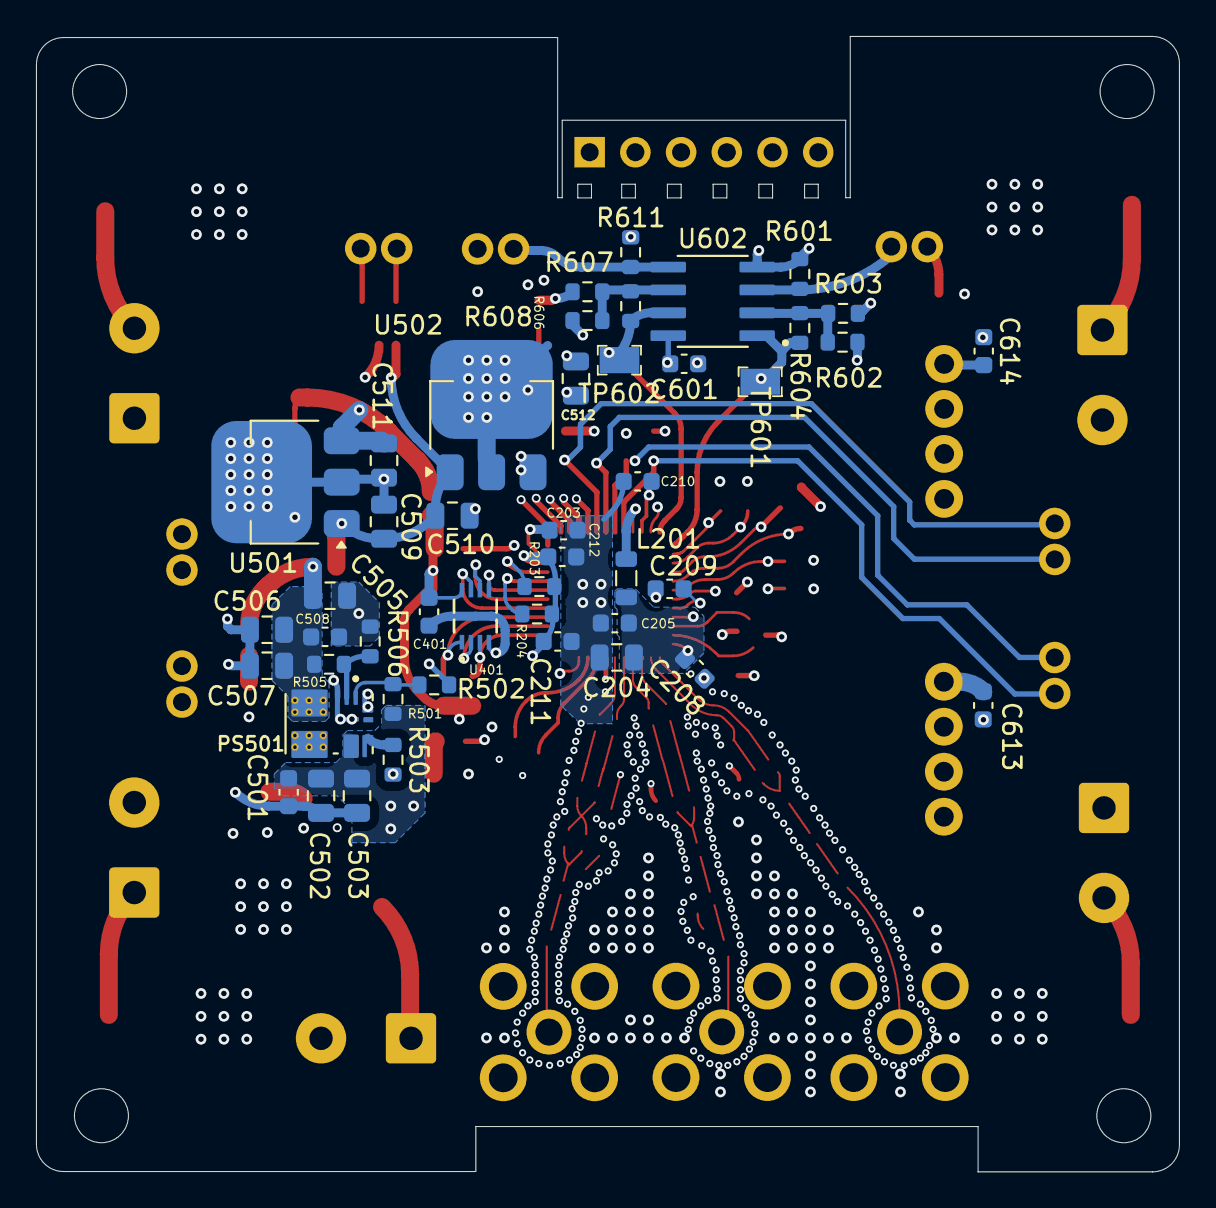
[picture p13: board Main Board - NDT.kicad_pcb from below]

Board: 6 copper layers, 63.5 x 63.1 mm, 155 parts (46 on the bottom side), 85 nets.
