yusufElnady/Ultrasound-NDT-Main-Board/(commit log)

2026-04-20 replaced baluns with passives & wirewound inductors as recommended, PCB is ready for routing and fencing
    [RF.kicad_sch]
2026-04-21 finished, just produce fabrication outputs
    [Main Board - NDT.kicad_pcb, Main Board - NDT.kicad_sch]
2026-04-28 added mounting holes and produced manufacturing files, ALL IS DONE Alhamdulillah
    [Main Board - NDT-B_Cu.gbr, Main Board - NDT-B_Mask.gbr, Main Board - NDT-B_Paste.gbr, Main Board - NDT-B_Silkscreen.gbr, Main Board - NDT-Edge_Cuts.gbr, Main Board - NDT-F_Cu.gbr, Main Board - NDT-F_Mask.gbr, Main Board - NDT-F_Paste.gbr]
